Celcius1/RPi-Arcade-HAT/Retropie Config files/custom_settings_for_gpio_matrix.txt

# dtc -W no-unit_address_vs_reg -I dts -O dtb -o ./overlays/gpio-matrix.dtbo gpio-matrix.dts
dtoverlay=gpio-matrix
