Celcius1/RPi-Arcade-HAT/Cable Clip.3mf

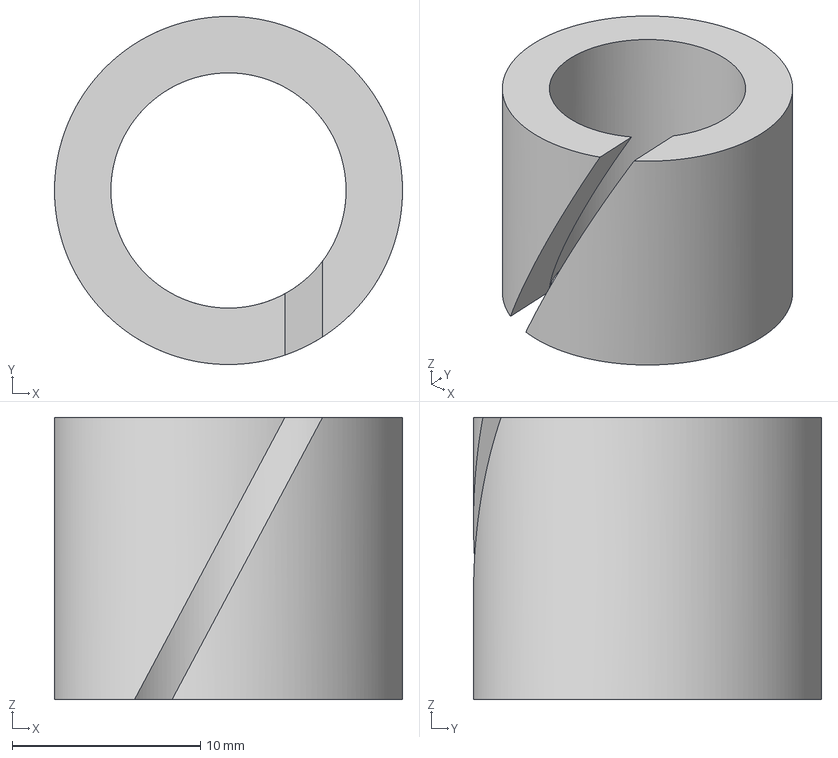
[picture p1: CAD file, 2024-01-26]
Cable Clip.3mf
18.5 x 18.5 x 15.0 mm
