Celcius1/RPi-Arcade-HAT/Board Bracket.3mf

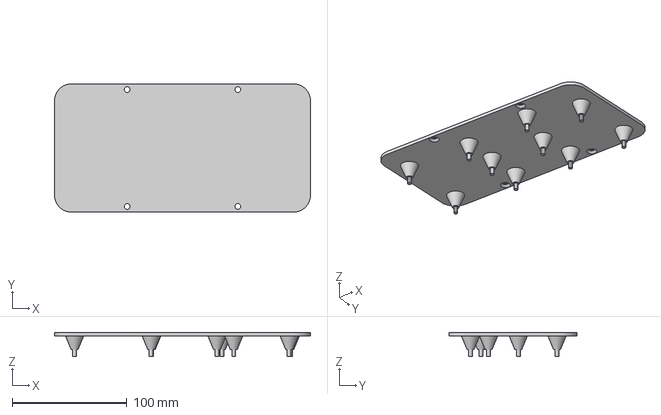
[picture p2: CAD file, 2023-09-16]
Board Bracket.3mf
223.5 x 112.1 x 21.0 mm
