Celcius1/RPi-Arcade-HAT/RPi Arcade Hat V0-3.kicad_pcb

## KiCad design RPi Arcade Hat V0-3.kicad_pcb (2024-01-26)

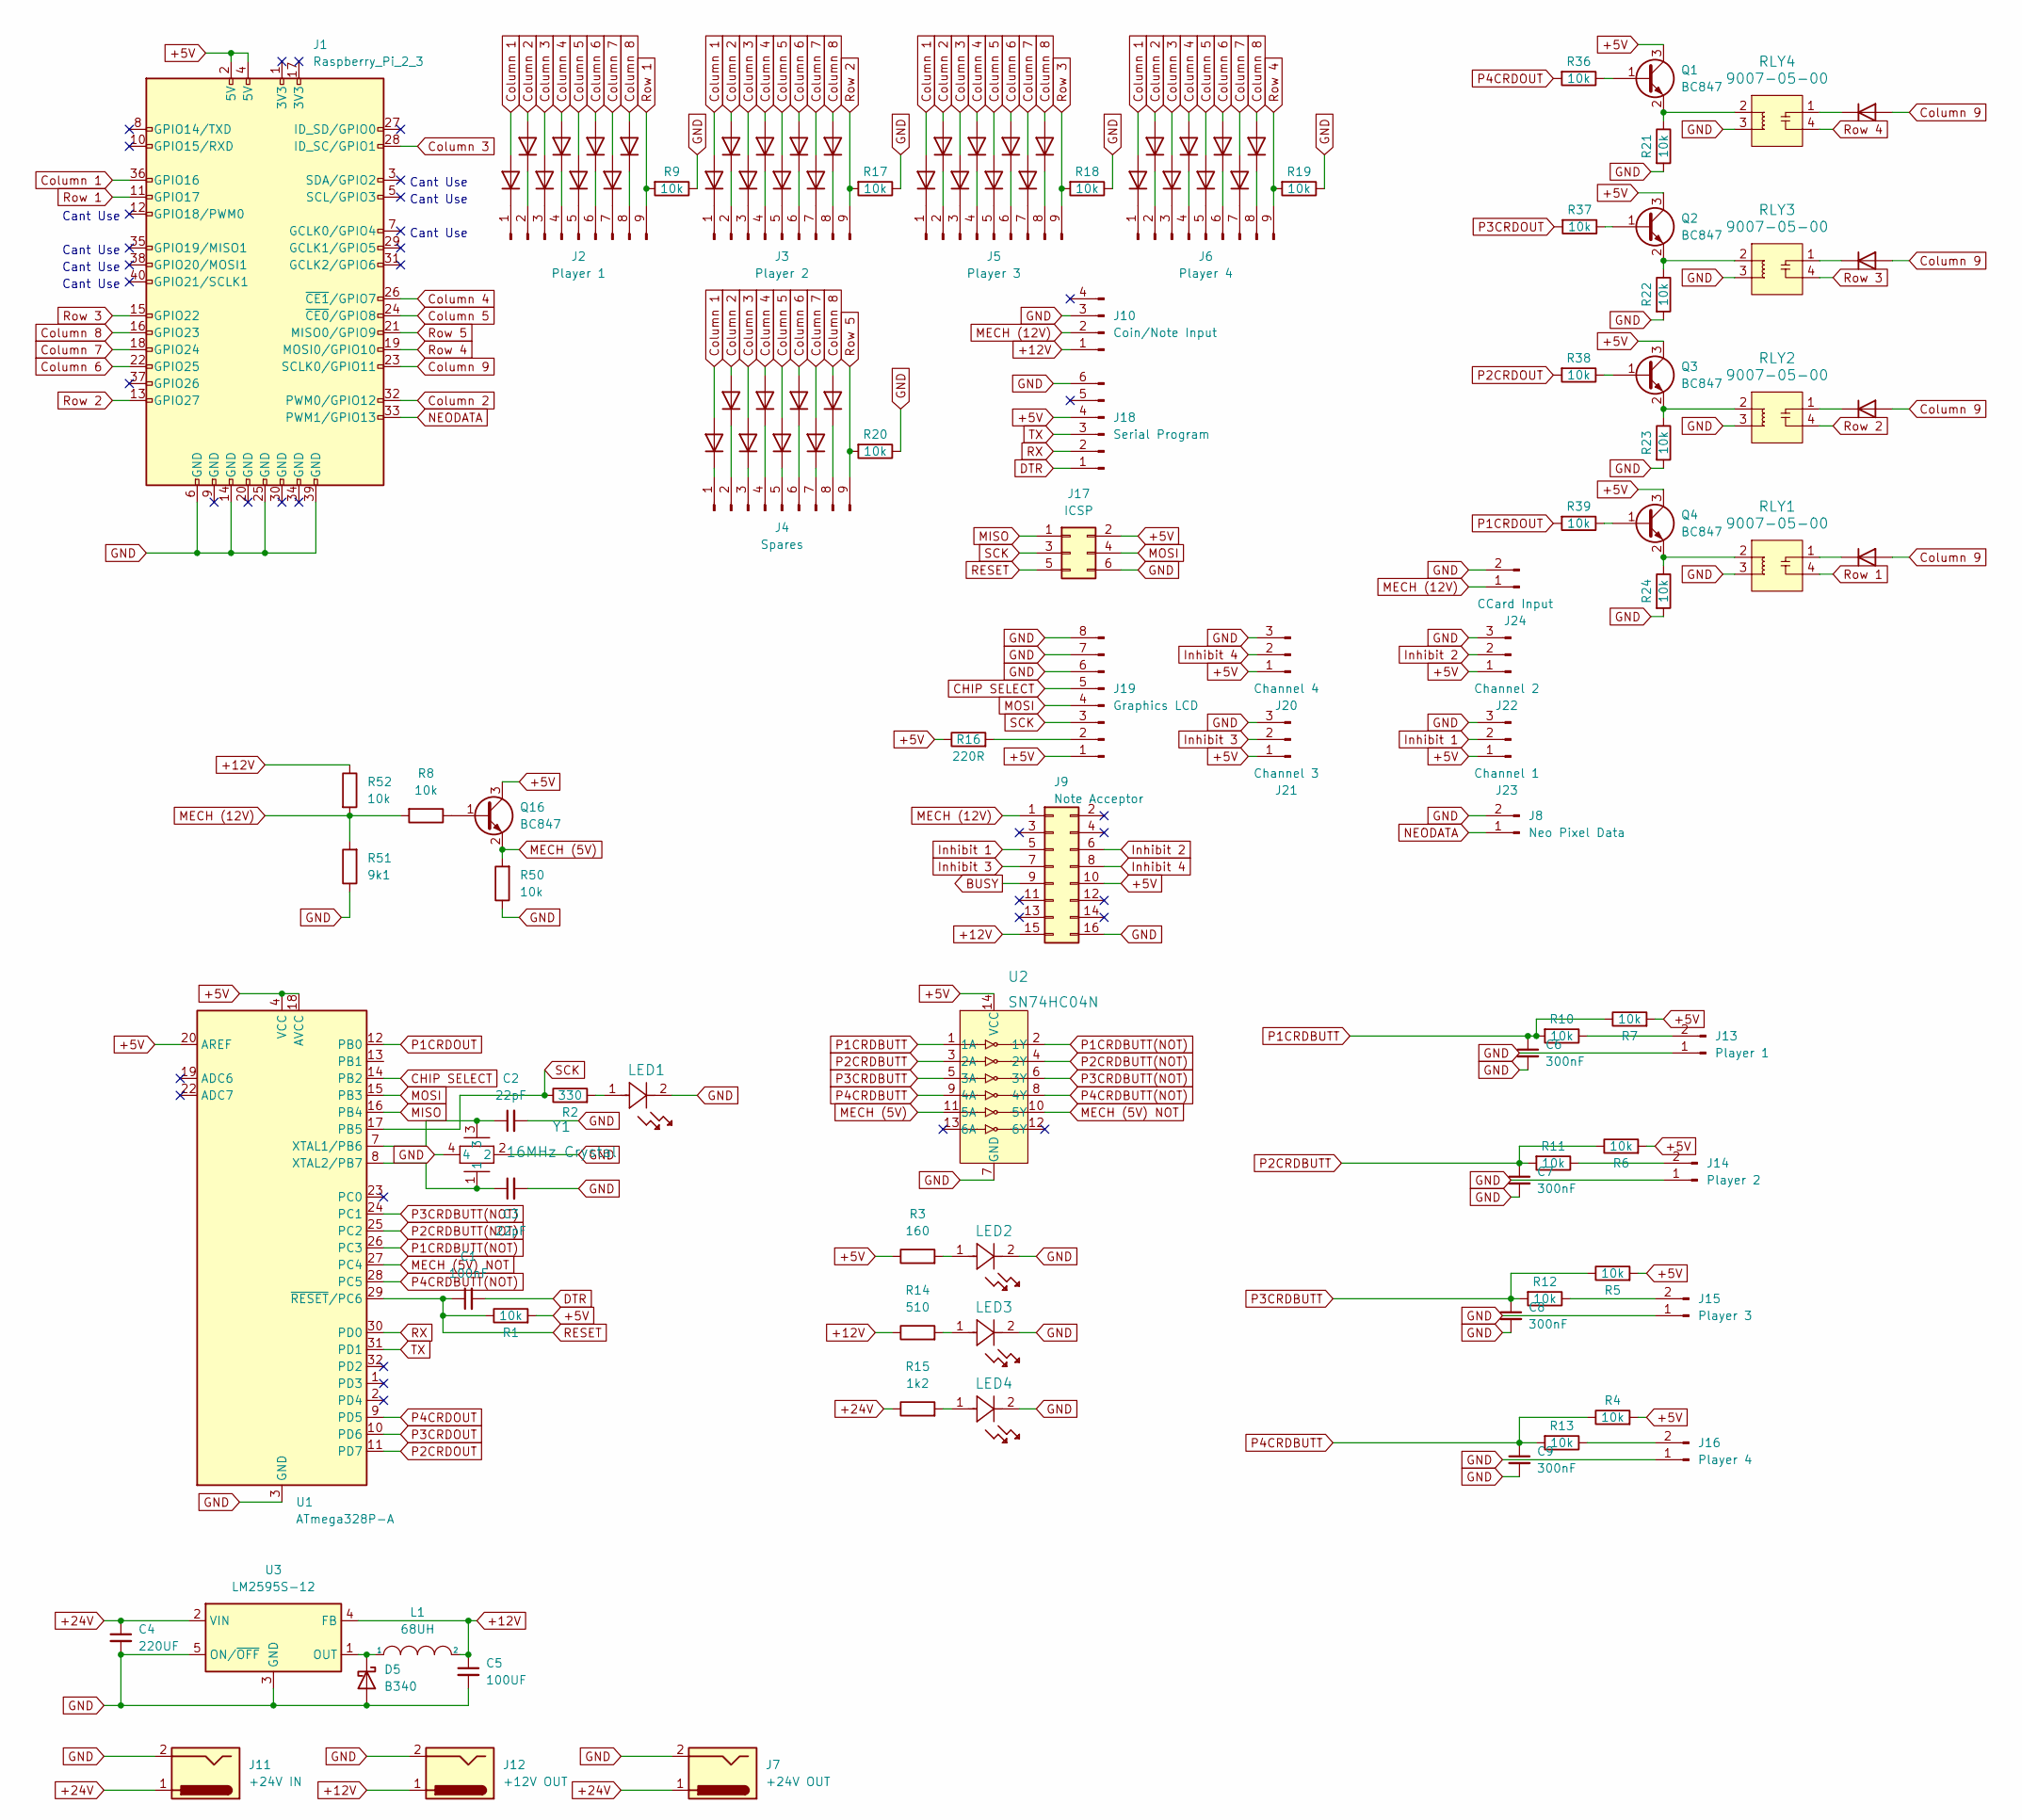
[picture p3: schematic RPi Arcade Hat V0-3.kicad_sch]

Parts:
C1: 100nF; C_1206_3216Metric
C2, C3: 22pF; C_1206_3216Metric
C4: 220UF; C_1210_3225Metric
C5: 100UF; C_1210_3225Metric
C6, C7, C8, C9: 300nF; C_1206_3216Metric
D1, D2, D3, D4, D6, D7, D8, D9, D10, D11, D12, D13, D14, D15, D16, D17, D18, D19, D20, D21, D22, D23, D24, D25, D26, D27, D28, D29, D30, D31, D32, D33, D34, D35, D36, D37, D38, D39, D40, D41, D42, D43, D44, D45: 1N4448W; D_SOD-123
D5: B340; D_SMC
J1: Raspberry_Pi_2_3; PinHeader_2x20_P2.54mm_Vertical
J2: Player 1; 282836-9
J3: Player 2; 282836-9
J4: Spares; 282836-9
J5: Player 3; 282836-9
J6: Player 4; 282836-9
J7: +24V OUT; BarrelJack_Horizontal
J8: Neo Pixel Data; CONN_1890963_PXC
J9: Note Acceptor; PinHeader_2x08_P2.54mm_Vertical
J10: Coin/Note Input; PinHeader_1x04_P2.54mm_Vertical
J11: +24V IN; BarrelJack_Horizontal
J12: +12V OUT; BarrelJack_Horizontal
J13: Player 1; CONN_1890963_PXC
J14: Player 2; CONN_1890963_PXC
J15: Player 3; CONN_1890963_PXC
J16: Player 4; CONN_1890963_PXC
J17: ICSP; PinHeader_2x03_P2.54mm_Vertical
J18: Serial Program; PinHeader_1x06_P2.54mm_Vertical
J19: Graphics LCD; PinHeader_1x08_P2.54mm_Vertical
J20: Channel 4; PinHeader_1x03_P2.54mm_Vertical
J21: Channel 3; PinHeader_1x03_P2.54mm_Vertical
J22: Channel 2; PinHeader_1x03_P2.54mm_Vertical
J23: Channel 1; PinHeader_1x03_P2.54mm_Vertical
J24: CCard Input; PinHeader_1x02_P2.54mm_Vertical
L1: 68UH; L_Bourns-SRN6028
LED1, LED2, LED3, LED4: 598-8270-107F; LED_8270-107F_DIA
Q1, Q2, Q3, Q4, Q16: BC847; SOT-23
R1, R4, R5, R6, R7, R8, R9, R10, R11, R12, R13, R17, R18, R19, R20, R21, R22, R23, R24, R36, R37, R38, R39, R50, R52: 10k; R_1206_3216Metric
R2: 330; R_1206_3216Metric
R3: 160; R_1206_3216Metric
R14: 510; R_1206_3216Metric
R15: 1k2; R_1206_3216Metric
R16: 220R; R_1206_3216Metric
R51: 9k1; R_1206_3216Metric
RLY1, RLY2, RLY3, RLY4: 9007-05-00; Relay_Reed_9007-05-00; MPN 9007-05-00; Digi-Key_PN 306-1062-ND
U1: ATmega328P-A; TQFP-32_7x7mm_P0.8mm
U2: SN74HC04N; SOIC-14_W3.9mm; MPN SN74HC04N; Digi-Key_PN 296-1566-5-ND
U3: LM2595S-12; TO-263-5_TabPin3
Y1: 16MHz Crystal; CRYSTAL_ABM3B_ABR

Connections:
+5V: J1.2 (5V), J1.4 (5V), J9.10, J17.2, J18.4, J19.1, J20.1, J21.1, J22.1, J23.1, Q1.3 (C), Q2.3 (C), Q3.3 (C), Q4.3 (C), Q16.3 (C), R1.2, R3.1, R4.2, R5.2, R6.2, R7.2, R16.1, U1.4 (VCC), U1.6 (VCC), U1.18 (AVCC), U1.20 (AREF), U2.14 (VCC)
+12V: C5.1, J9.15, J10.1, J12.1, L1.2, R14.1, R52.1, U3.4 (FB)
+24V: C4.1, J7.1, J11.1, R15.1, U3.2 (VIN)
BUSY: J9.9
CHIP SELECT: J19.5, U1.14 (PB2)
Column 1: D1.2 (A), D10.2 (A), D18.2 (A), D26.2 (A), D34.2 (A), J1.36 (GPIO16)
Column 2: D2.2 (A), D11.2 (A), D19.2 (A), D27.2 (A), D35.2 (A), J1.32 (PWM0/GPIO12)
Column 3: D3.2 (A), D12.2 (A), D20.2 (A), D28.2 (A), D36.2 (A), J1.28 (ID_SC/GPIO1)
Column 4: D4.2 (A), D13.2 (A), D21.2 (A), D29.2 (A), D37.2 (A), J1.26 (~CE1/GPIO7)
Column 5: D6.2 (A), D14.2 (A), D22.2 (A), D30.2 (A), D38.2 (A), J1.24 (~CE0/GPIO8)
Column 6: D7.2 (A), D15.2 (A), D23.2 (A), D31.2 (A), D39.2 (A), J1.22 (GPIO25)
Column 7: D8.2 (A), D16.2 (A), D24.2 (A), D32.2 (A), D40.2 (A), J1.18 (GPIO24)
Column 8: D9.2 (A), D17.2 (A), D25.2 (A), D33.2 (A), D41.2 (A), J1.16 (GPIO23)
Column 9: D42.2 (A), D43.2 (A), D44.2 (A), D45.2 (A), J1.23 (SCLK0/GPIO11)
DTR: C1.2, J18.1
GND: C2.2, C3.2, C4.2, C5.2, C6.2, C7.2, C8.2, C9.2, D5.2 (A), J1.6 (GND), J1.14 (GND), J1.25 (GND), J1.39 (GND), J7.2, J8.2, J9.16, J10.3, J11.2, J12.2, J13.1, J14.1, J15.1, J16.1, J17.6, J18.6, J19.6, J19.7, J19.8, J20.3, J21.3, J22.3, J23.3, J24.2, LED1.2, LED2.2, LED3.2, LED4.2, R9.1, R17.1, R18.1, R19.1, R20.1, R21.2, R22.2, R23.2, R24.2, R50.1, R51.1, RLY1.3, RLY2.3, RLY3.3, RLY4.3, U1.3 (GND), U1.5 (GND), U1.21 (GND), U2.7 (GND), U3.3 (GND), U3.5 (ON/~OFF), Y1.2, Y1.4
Inhibit 1: J9.5, J23.2
Inhibit 2: J9.6, J22.2
Inhibit 3: J9.7, J21.2
Inhibit 4: J9.8, J20.2
MECH (5V): Q16.2 (E), R50.2, U2.11 (5A)
MECH (5V) NOT: U1.27 (PC4), U2.10 (5Y)
MECH (12V): J9.1, J10.2, J24.1, R8.2, R51.2, R52.2
MISO: J17.1, U1.16 (PB4)
MOSI: J17.4, J19.4, U1.15 (PB3)
NEODATA: J1.33 (PWM1/GPIO13), J8.1
unnamed: D1.1 (K), J2.1
unnamed: D2.1 (K), J2.2
unnamed: D3.1 (K), J2.3
unnamed: D4.1 (K), J2.4
unnamed: D5.1 (K), L1.1, U3.1 (OUT)
unnamed: D6.1 (K), J2.5
unnamed: D7.1 (K), J2.6
unnamed: D8.1 (K), J2.7
unnamed: D9.1 (K), J2.8
unnamed: D10.1 (K), J3.1
unnamed: D11.1 (K), J3.2
unnamed: D12.1 (K), J3.3
unnamed: D13.1 (K), J3.4
unnamed: D14.1 (K), J3.5
unnamed: D15.1 (K), J3.6
unnamed: D16.1 (K), J3.7
unnamed: D17.1 (K), J3.8
unnamed: D18.1 (K), J5.1
unnamed: D19.1 (K), J5.2
unnamed: D20.1 (K), J5.3
unnamed: D21.1 (K), J5.4
unnamed: D22.1 (K), J5.5
unnamed: D23.1 (K), J5.6
unnamed: D24.1 (K), J5.7
unnamed: D25.1 (K), J5.8
unnamed: D26.1 (K), J6.1
unnamed: D27.1 (K), J6.2
unnamed: D28.1 (K), J6.3
unnamed: D29.1 (K), J6.4
unnamed: D30.1 (K), J6.5
unnamed: D31.1 (K), J6.6
unnamed: D32.1 (K), J6.7
unnamed: D33.1 (K), J6.8
unnamed: D34.1 (K), J4.1
unnamed: D35.1 (K), J4.2
unnamed: D36.1 (K), J4.3
unnamed: D37.1 (K), J4.4
unnamed: D38.1 (K), J4.5
unnamed: D39.1 (K), J4.6
unnamed: D40.1 (K), J4.7
unnamed: D41.1 (K), J4.8
unnamed: D42.1 (K), RLY4.1
unnamed: D43.1 (K), RLY3.1
unnamed: D44.1 (K), RLY2.1
unnamed: D45.1 (K), RLY1.1
unnamed: J13.2, R10.1
unnamed: J14.2, R11.1
unnamed: J15.2, R12.1
unnamed: J16.2, R13.1
unnamed: J19.2, R16.2
unnamed: LED1.1, R2.2
unnamed: LED2.1, R3.2
unnamed: LED3.1, R14.2
unnamed: LED4.1, R15.2
unnamed: Q1.1 (B), R36.1
unnamed: Q1.2 (E), R21.1, RLY4.2
unnamed: Q2.1 (B), R37.1
unnamed: Q2.2 (E), R22.1, RLY3.2
unnamed: Q3.1 (B), R38.1
unnamed: Q3.2 (E), R23.1, RLY2.2
unnamed: Q4.1 (B), R39.1
unnamed: Q4.2 (E), R24.1, RLY1.2
unnamed: Q16.1 (B), R8.1
unnamed: C2.1, U1.7 (XTAL1/PB6), Y1.3
unnamed: C3.1, U1.8 (XTAL2/PB7), Y1.1
P1CRDBUTT: C6.1, R7.1, R10.2, U2.1 (1A)
P1CRDBUTT(NOT): U1.26 (PC3), U2.2 (1Y)
P1CRDOUT: R39.2, U1.12 (PB0)
P2CRDBUTT: C7.1, R6.1, R11.2, U2.3 (2A)
P2CRDBUTT(NOT): U1.25 (PC2), U2.4 (2Y)
P2CRDOUT: R38.2, U1.11 (PD7)
P3CRDBUTT: C8.1, R5.1, R12.2, U2.5 (3A)
P3CRDBUTT(NOT): U1.24 (PC1), U2.6 (3Y)
P3CRDOUT: R37.2, U1.10 (PD6)
P4CRDBUTT: C9.1, R4.1, R13.2, U2.9 (4A)
P4CRDBUTT(NOT): U1.28 (PC5), U2.8 (4Y)
P4CRDOUT: R36.2, U1.9 (PD5)
RESET: C1.1, J17.5, R1.1, U1.29 (~RESET/PC6)
RX: J18.2, U1.30 (PD0)
Row 1: J1.11 (GPIO17), J2.9, R9.2, RLY1.4
Row 2: J1.13 (GPIO27), J3.9, R17.2, RLY2.4
Row 3: J1.15 (GPIO22), J5.9, R18.2, RLY3.4
Row 4: J1.19 (MOSI0/GPIO10), J6.9, R19.2, RLY4.4
Row 5: J1.21 (MISO0/GPIO9), J4.9, R20.2
SCK: J17.3, J19.3, R2.1, U1.17 (PB5)
TX: J18.3, U1.31 (PD1)

Notes on the sheet:
Cant Use

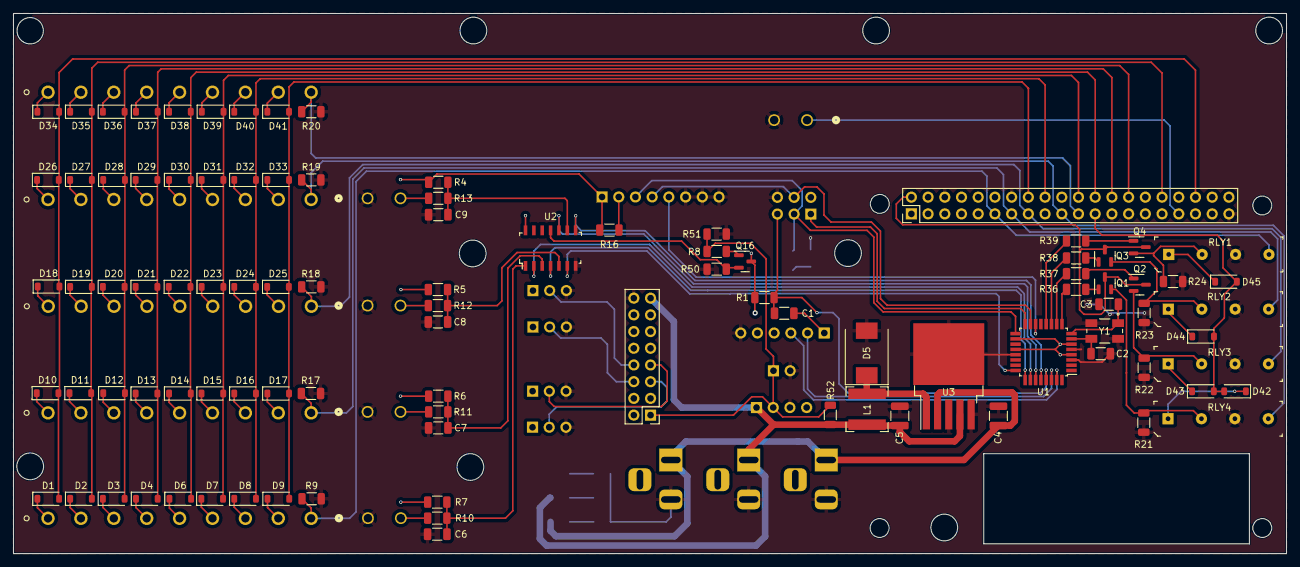
[picture p4: board RPi Arcade Hat V0-3.kicad_pcb from above]

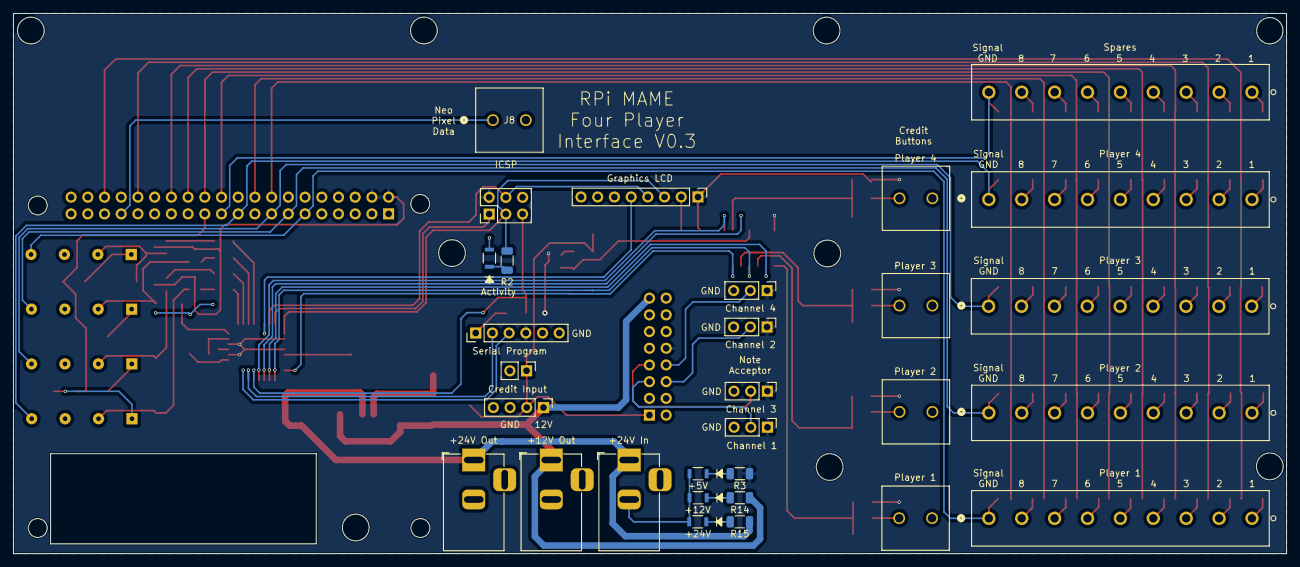
[picture p5: board RPi Arcade Hat V0-3.kicad_pcb from below]

Board: 2 copper layers, 193.5 x 82.1 mm, 127 parts (30 on the bottom side), 111 nets.
