Celcius1/RPi-Arcade-HAT/Coin Interface Adapter/Coin Adapter/Coin Adapter.kicad_pcb

## KiCad design Coin Interface Adapter/Coin Adapter/Coin Adapter.kicad_pcb (2023-06-07)

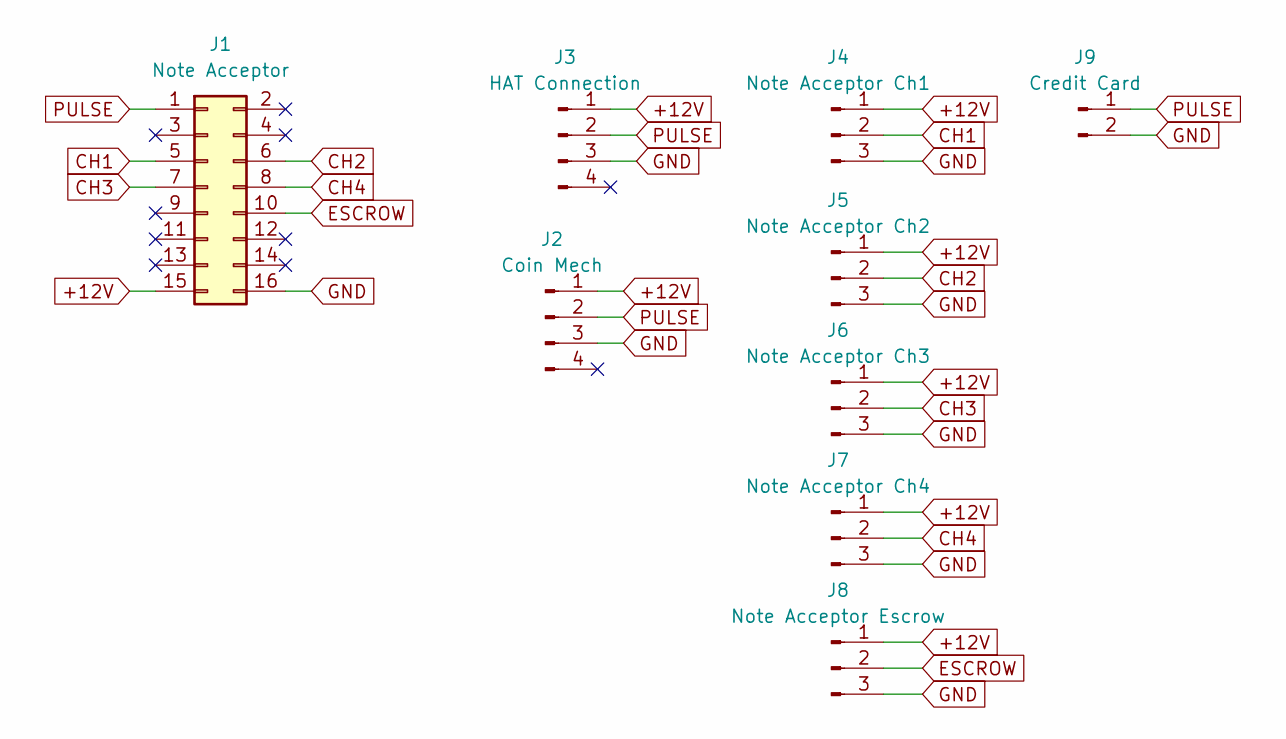
[picture p6: schematic Coin Adapter.kicad_sch]

Parts:
J1: Note Acceptor; PinHeader_2x08_P2.54mm_Vertical
J2: Coin Mech; PinHeader_1x04_P2.54mm_Vertical
J3: HAT Connection; PinHeader_1x04_P2.54mm_Vertical
J4: Note Acceptor Ch1; PinHeader_1x03_P2.54mm_Vertical
J5: Note Acceptor Ch2; PinHeader_1x03_P2.54mm_Vertical
J6: Note Acceptor Ch3; PinHeader_1x03_P2.54mm_Vertical
J7: Note Acceptor Ch4; PinHeader_1x03_P2.54mm_Vertical
J8: Note Acceptor Escrow; PinHeader_1x03_P2.54mm_Vertical
J9: Credit Card; PinHeader_1x02_P2.54mm_Vertical

Connections:
+12V: J1.15, J2.1, J3.1, J4.1, J5.1, J6.1, J7.1, J8.1
CH1: J1.5, J4.2
CH2: J1.6, J5.2
CH3: J1.7, J6.2
CH4: J1.8, J7.2
ESCROW: J1.10, J8.2
GND: J1.16, J2.3, J3.3, J4.3, J5.3, J6.3, J7.3, J8.3, J9.2
PULSE: J1.1, J2.2, J3.2, J9.1

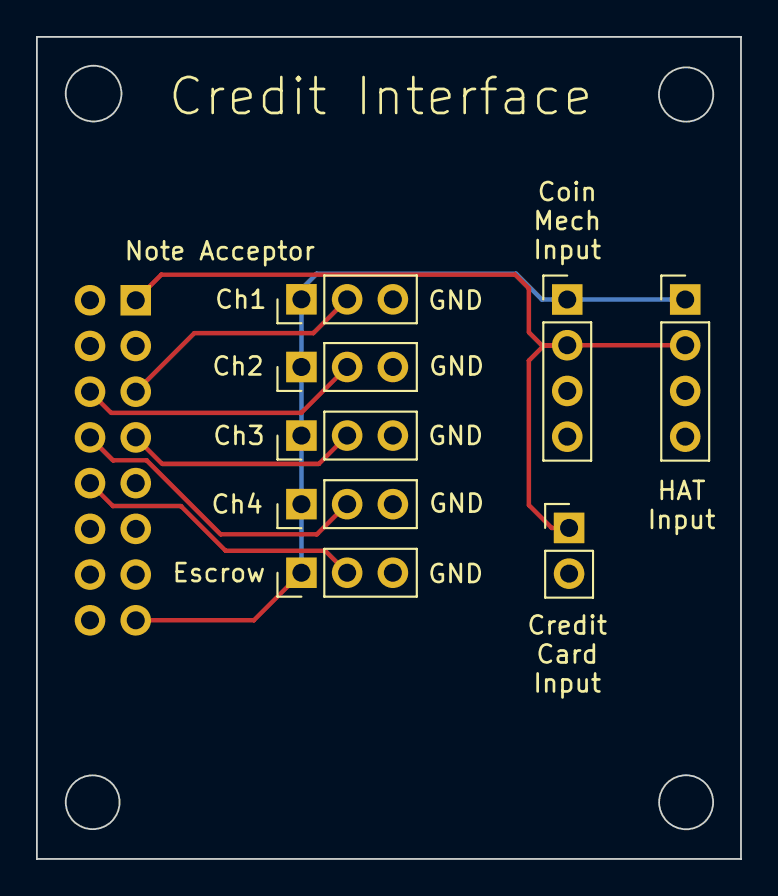
[picture p7: board Coin Adapter.kicad_pcb from above]

Board: 2 copper layers, 39.1 x 45.7 mm, 9 parts (1 on the bottom side), 8 nets.
