Celcius1/RPi-Arcade-HAT/(commit log)

2023-06-07 Initial Upload
    [Coin Adapter-B_Cu.gbl, Coin Adapter-B_Mask.gbs, Coin Adapter-B_Paste.gbp, Coin Adapter-B_Silkscreen.gbo, Coin Adapter-Edge_Cuts.gm1, Coin Adapter-F_Cu.gtl, Coin Adapter-F_Mask.gts, Coin Adapter-F_Paste.gtp]
2023-06-17 Error fixed
    Found a wiring error in the circuit for the credit input, had it wired for NC logic (Active High), when should've been NO(Active Low)
    [RPi Arcade Hat V0-3.kicad_pcb, RPi Arcade Hat V0-3.kicad_sch]
2023-06-18 PCB Redesigned as a Four Layer Board
    I decided to redesign the PCB utilising screw terminals instead of IDC plugs, also made the PCB into a four layer board and Generated gerber's need to fix some silk screen details
    [RPi Arcade Hat V0-3-B_Cu.gbl, RPi Arcade Hat V0-3-B_Mask.gbs, RPi Arcade Hat V0-3-B_Paste.gbp, RPi Arcade Hat V0-3-B_Silkscreen.gbo, RPi Arcade Hat V0-3-Edge_Cuts.gm1, RPi Arcade Hat V0-3-F_Cu.gtl, RPi Arcade Hat V0-3-F_Mask.gts, RPi Arcade Hat V0-3-F_Paste.gtp]
2023-06-19 Minor Refinements, and Final Gerbers
    Made some final refinements, and made sure that silkscreens were also correct before getting PCB's made
    [RPi Arcade Hat V0-3-B_Cu.gbl, RPi Arcade Hat V0-3-B_Mask.gbs, RPi Arcade Hat V0-3-B_Paste.gbp, RPi Arcade Hat V0-3-B_Silkscreen.gbo, RPi Arcade Hat V0-3-Edge_Cuts.gm1, RPi Arcade Hat V0-3-F_Cu.gtl, RPi Arcade Hat V0-3-F_Mask.gts, RPi Arcade Hat V0-3-F_Paste.gtp]
2023-06-19 Adjusted PCB so it will manufacture as one
    JLCPCB had issues with the gerbers adjusted so it is seen as one design otherwise extra processing fees would apply
    [RPi Arcade Hat V0-3-B_Cu.gbl, RPi Arcade Hat V0-3-B_Mask.gbs, RPi Arcade Hat V0-3-B_Paste.gbp, RPi Arcade Hat V0-3-B_Silkscreen.gbo, RPi Arcade Hat V0-3-Edge_Cuts.gm1, RPi Arcade Hat V0-3-F_Cu.gtl, RPi Arcade Hat V0-3-F_Mask.gts, RPi Arcade Hat V0-3-F_Paste.gtp]
2023-06-20 Found Error on Debounce Circuit
    As I was going through the schematic I found I wired the button credit input incorrect, and had the logic level held high then pulling to GND, and I should've used an inverter on the output, went with a simple fix, and ended up removing the extra components and changing the connection on the button from GND to +5V
    [RPi Arcade Hat V0-3.kicad_pcb, RPi Arcade Hat V0-3.kicad_sch]
2023-06-20 Reverted Changes
    [RPi Arcade Hat V0-3.kicad_sch]
2023-06-21 Current Changes To Repository
    [RPi Arcade Hat V0-3.kicad_pcb]
2023-07-12 Board Redesign
    As ATMega328 are back in stock I have returned to using a MCU and adjust the design now it is a double sided design and not an expensive multi layered design
2023-07-13 Adjust Design to PCBWay limitations
    [RPi Arcade Hat V0-3.kicad_pcb, RPi Arcade Hat V0-3.kicad_sch]
2023-07-13 Updated to KiCAD 7 format
    [RPi Arcade Hat V0-3.kicad_pcb, RPi Arcade Hat V0-3.kicad_sch]
2023-08-03 Added Arduino Code
    [RPi Arcade Hat V0-3.kicad_pcb, RPi Arcade Hat V0-3.kicad_sch]
2023-08-12 Changes made after testing
    [RPi Arcade Hat V0-3.kicad_pcb, RPi Arcade Hat V0-3.kicad_sch]
2023-08-24 Fixed Input Matrix
    [RPi Arcade Hat V0-3.kicad_pcb, RPi Arcade Hat V0-3.kicad_sch]
2023-09-16 Additional Fixes
    [Board Bracket.3mf, RPi Arcade Hat V0-3.kicad_sch, RPi Arcade Hat V0-3.step]
2024-01-26 fixes and updates
    [Cable Clip.3mf, RPi Arcade Hat V0-3.kicad_pcb, RPi Arcade Hat V0-3.kicad_sch]
